ytani01/OttoPi/docs/index.md

OttoPi
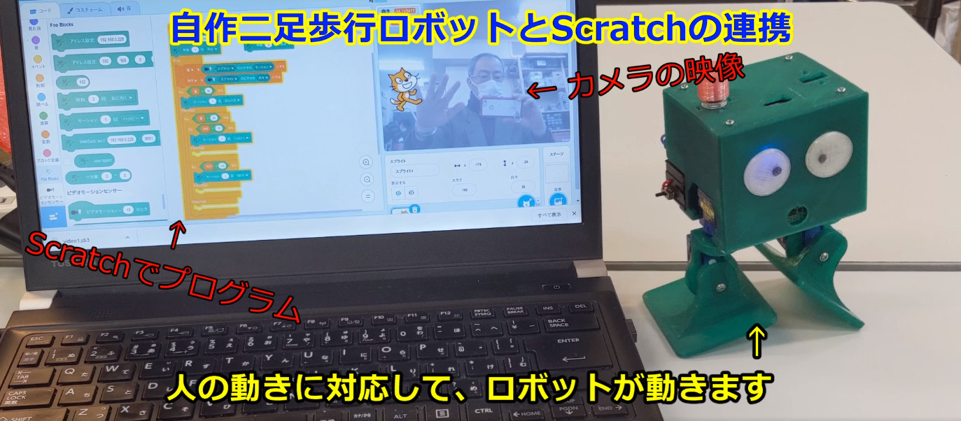
[picture p1: docs/media/OttoPi-Scratch.mp4.jpg]
OttoPi (http://www.ytani.net:8080/tmp/OttoPi/OttoPi-Scratch.mp4)

[Youtube](https://youtu.be/tdhGacsOuL4)

# OttoPi: Otto DIY like biped robot for Raspberry Pi (Zero)

## About

Raspberry Pi Zeroをベースに、
[Otto DIY](https://www.ottodiy.com/)のような
二足歩行ロボットを作って見ました。

Raspberry Piがベースと言うことで、
本家の[Otto DIY](https://www.ottodiy.com/)とは違い、
以下のような特徴があります。

* 距離センサーで障害物を検知して、自動的に歩き回ります。(自動運転モード）
* BLE経由で、スクラッチ(の専用拡張機能)から、制御することができます。(距離センサーの値も取得可能)
* Wi-Fi経由で、スマートフォンからマニュアル操作するこができます。
* 音声合成機能内蔵(OpenJTalk)で、
自由な文章(日本語)をしゃべらせることができます。
* Scrtchの独自拡張機能を利用して、Scratchからロボットを制御できます。

## Control with Scratch 3.0

0. (for Windows) Download and UnZip [`Scratch Link 1.3.66.0`](https://github.com/ytani01/OttoPi/raw/master/ScratchLink/ScratchLink-1.3.66.0.zip)
1. (for PC) run ``Scratch Link``
2. [Scratch & 専用拡張機能](https://ytani01.github.io/scratch-gui/)

## Control with smartphone or PC

``http://{IP address}:5000/``

-----

以下、まだまだドキュメントが未整備で、
最新の状態にできていません。
m(_ _)m

## 3D model

T.B.D

## Hardware

### BOM (Bill of Materials)

| Item | Qty |
|---|-----|
| Raspberry Pi Zero WH | x1 |
| 18650 battery | x1 |
| battery box | x1 |
| SG-90 Servo Motor | x4 | 

### T.B.D.

## Install software

### purge pulseaudio packages

現状、pulseaudioがあると、音声が出ません。
以下のように、pulseaudioを削除してください。

```bash
$ sudo apt purge pulseaudio\*
```

### make Python3 venv

```bash
$ cd ${HOME}
$ python3 -m venv env1
```

### download

```bash
$ cd ~/env1
$ git clone https://www.github.com/ytani01/OttoPi.git
```

### install 

```bash
$ cd ~/env1/OttoPi
$ ./setup.sh
```

## References

* [pigpio](http://abyz.me.uk/rpi/pigpio/)
* [Otto DIY](https://www.ottodiy.com/)
* [Open JTalk](http://open-jtalk.sp.nitech.ac.jp/)
