ytani01/OttoPi/pcb/OttoPi10-RPi3A-HAT/KiCAD/OttoPi10-RPi3A-HAT.pdf

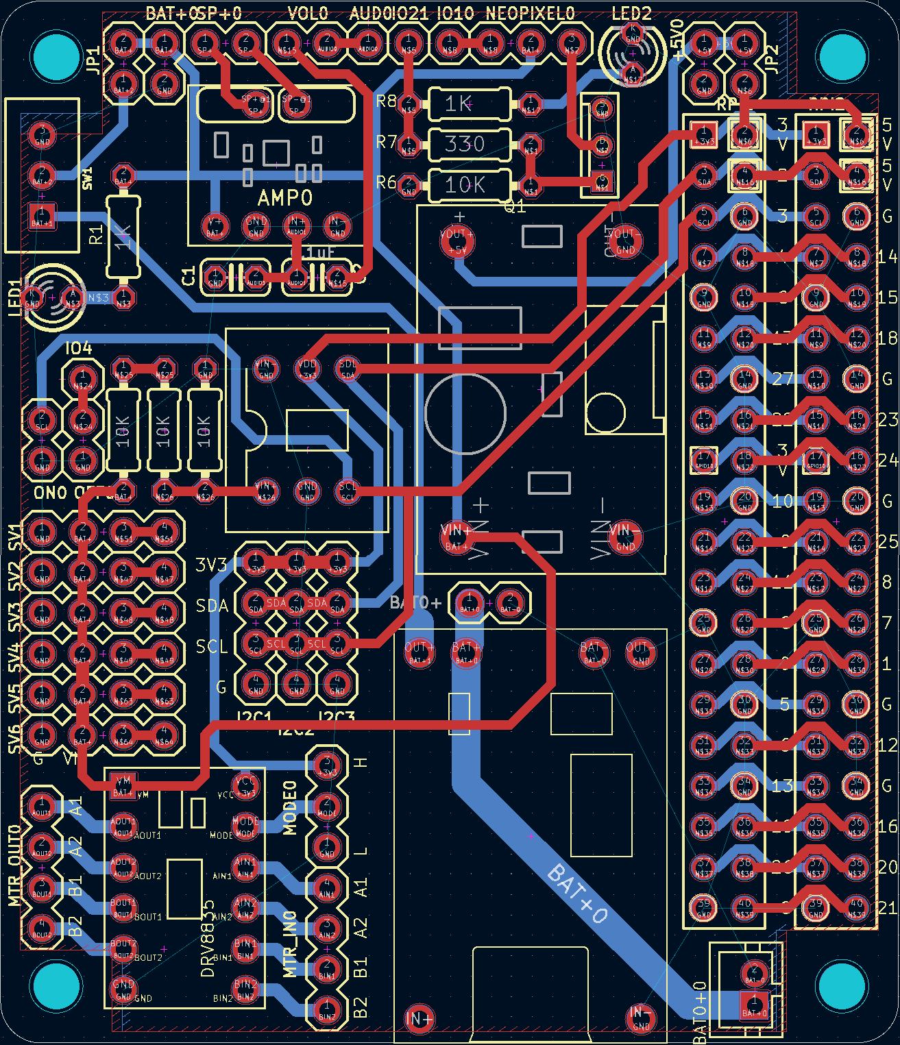
[picture p2: page 1]
