ytani01/OttoPi/docs/media/20210413a1-1.png

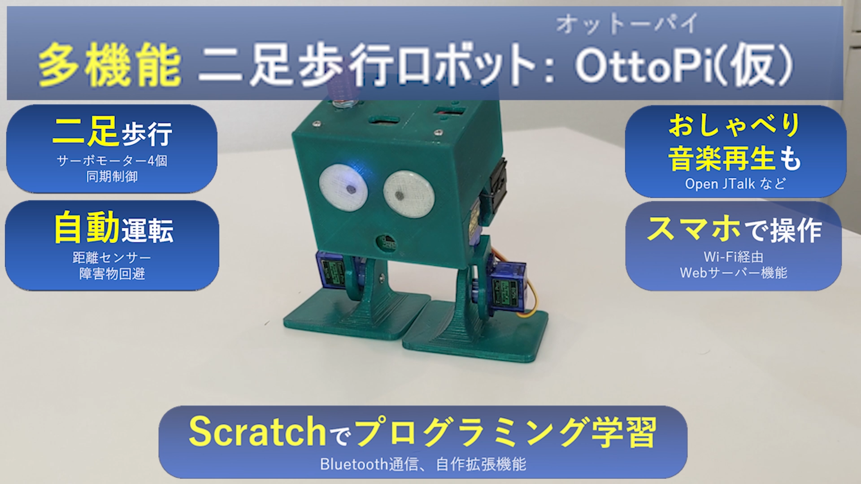
docs/media/20210413a1-1.png
