ytani01/OttoPi/docs/media/20210413a1-2.jpg

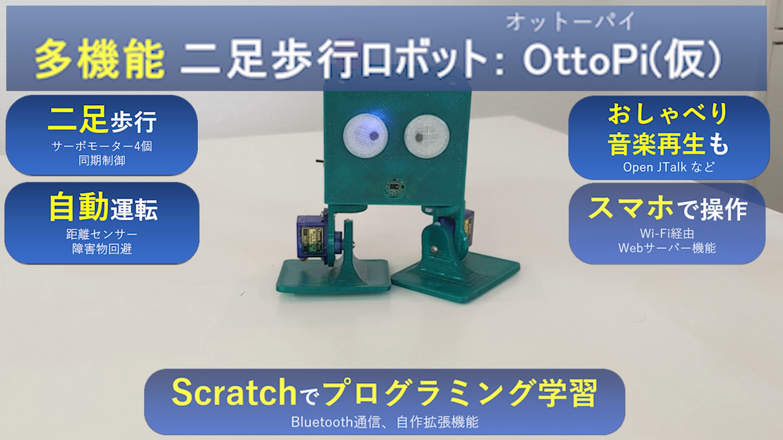
docs/media/20210413a1-2.jpg
