ytani01/OttoPi/docs/media/OttoPi-Web1.png

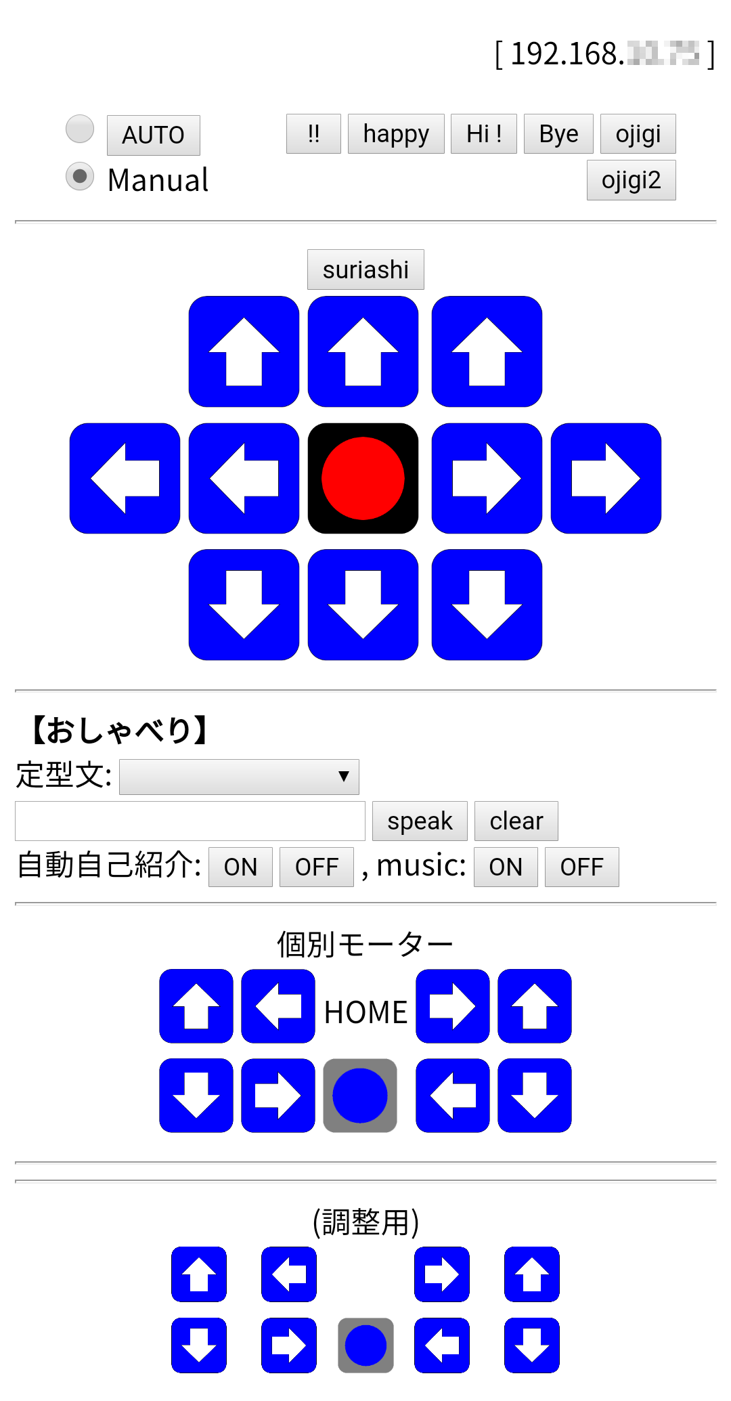
docs/media/OttoPi-Web1.png
