ytani01/OttoPi/docs/media/OttoPi.png

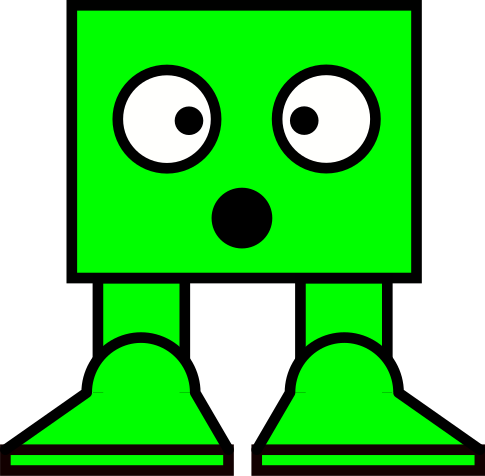
docs/media/OttoPi.png
