ytani01/OttoPi/pcb/OttoPi09-RPi3A-HAT/OttoPi09-Rpi3A-HAT.png

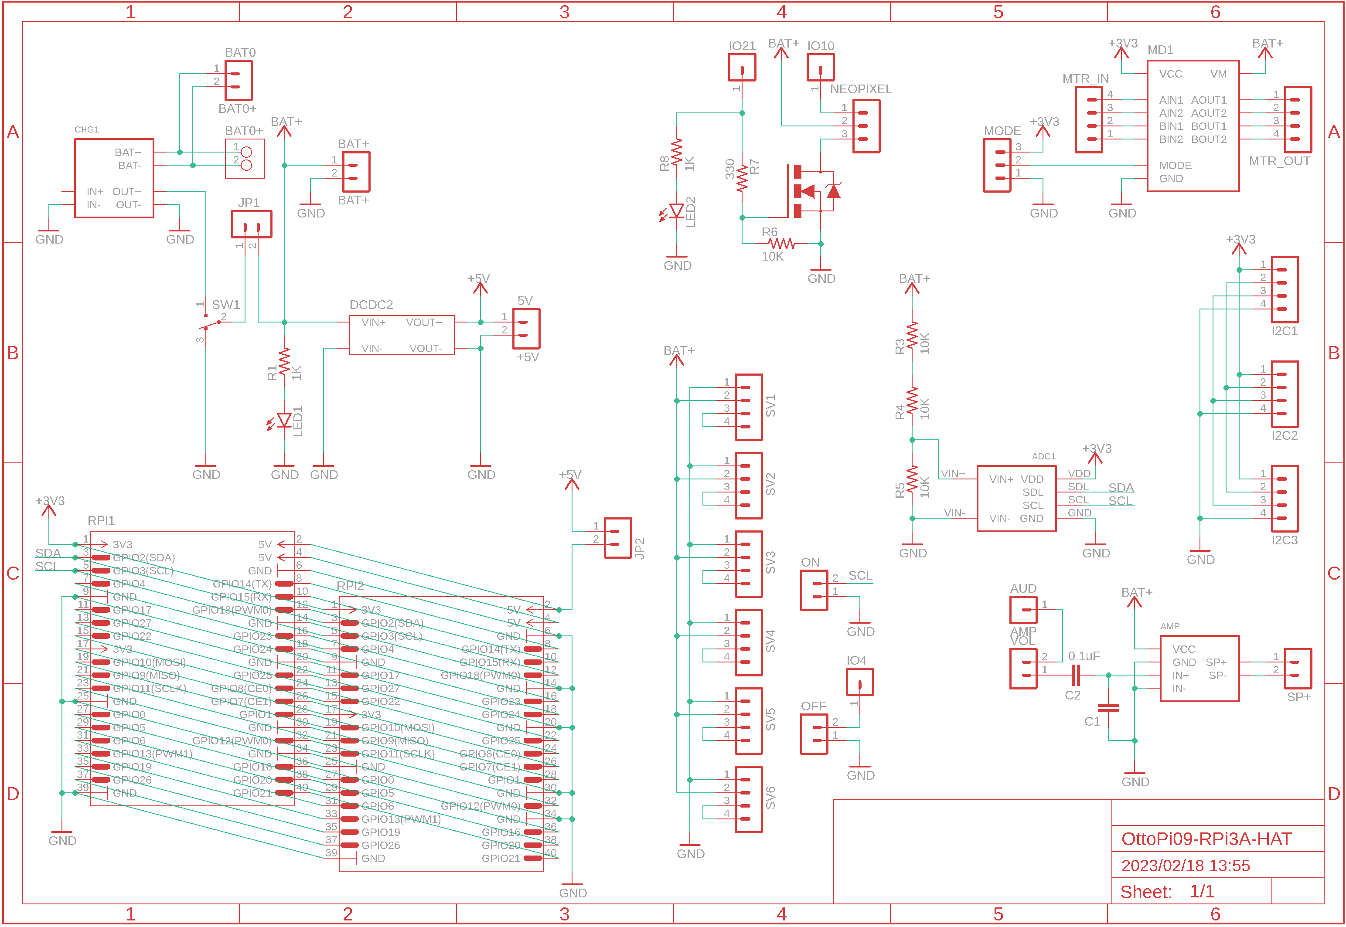
pcb/OttoPi09-RPi3A-HAT/OttoPi09-Rpi3A-HAT.png
