ytani01/OttoPi/static/images/button_blue1.png

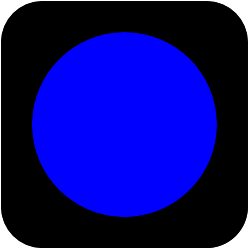
static/images/button_blue1.png
