ytani01/OttoPi/static/images/button_blue2.png

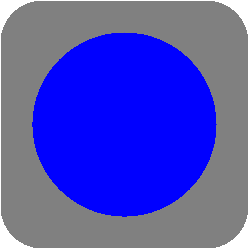
static/images/button_blue2.png
