ytani01/OttoPi/static/images/button_center.png

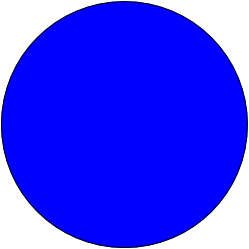
static/images/button_center.png
