ytani01/OttoPi/static/images/button_down.png

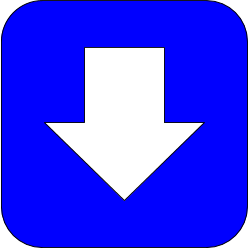
static/images/button_down.png
