ytani01/OttoPi/static/images/button_left.png

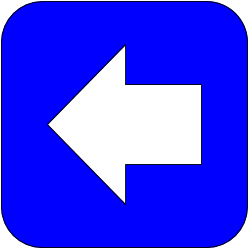
static/images/button_left.png
