ytani01/OttoPi/static/images/button_right.png

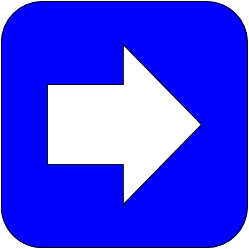
static/images/button_right.png
