ytani01/OttoPi/static/images/button_up.png

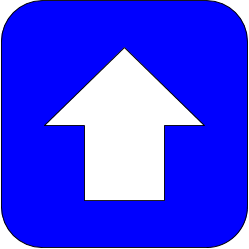
static/images/button_up.png
