ytani01/OttoPi/static/images/Robot_remocon.png

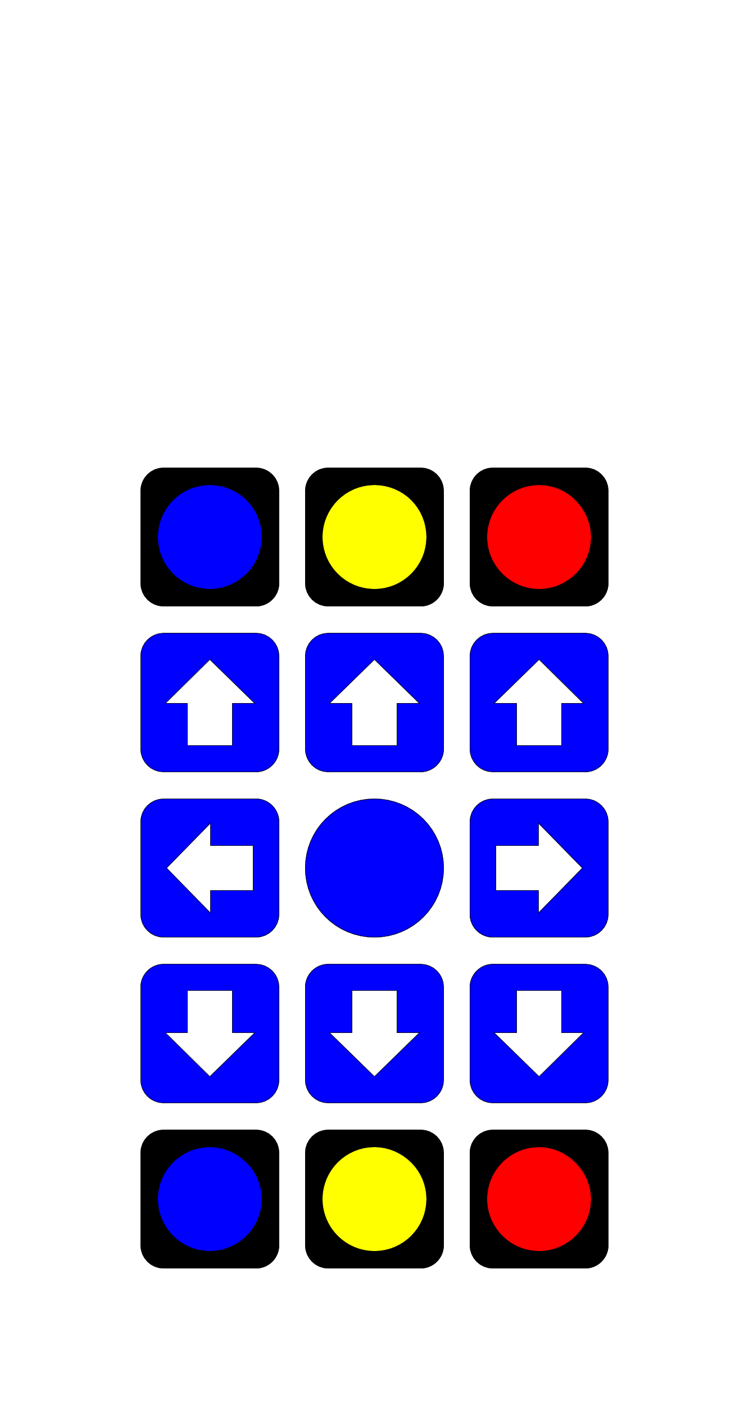
static/images/Robot_remocon.png
