ytani01/OttoPi/(list of files, drawings)

Other design files:
pcb/Fritzing/ButtonLED01a.fzz
pcb/Fritzing/OttoPi-01.fzz
pcb/Fritzing/OttoPi-01a.fzz
pcb/Fritzing/OttoPi-01b.fzz
pcb/Fritzing/OttoPi-02.fzz
pcb/Fritzing/OttoPi-03.fzz
pcb/Fritzing/OttoPi-04.fzz
pcb/Fritzing/OttoPi-05a.fzz
pcb/Fritzing/OttoPi-05b.fzz
pcb/Fritzing/OttoPi-05c.fzz
pcb/Fritzing/OttoPi-06a.fzz
pcb/Fritzing/OttoPi-06b.fzz
pcb/Fritzing/OttoPi-07a.fzz
pcb/Fritzing/OttoPi-07b.fzz
pcb/Fritzing/OttoPi-07c.fzz
pcb/Fritzing/OttoPi-08a.fzz
pcb/Fritzing/OttoPi-08b.fzz
pcb/Fritzing/OttoPi-universal1.fzz
