ytani01/OttoPi/pcb/OttoPi10-RPi3A-HAT/KiCAD/OttoPi10-RPi3A-HAT.kicad_pcb

## KiCad design pcb/OttoPi10-RPi3A-HAT/KiCAD/OttoPi10-RPi3A-HAT.kicad_pcb (2025-03-08)

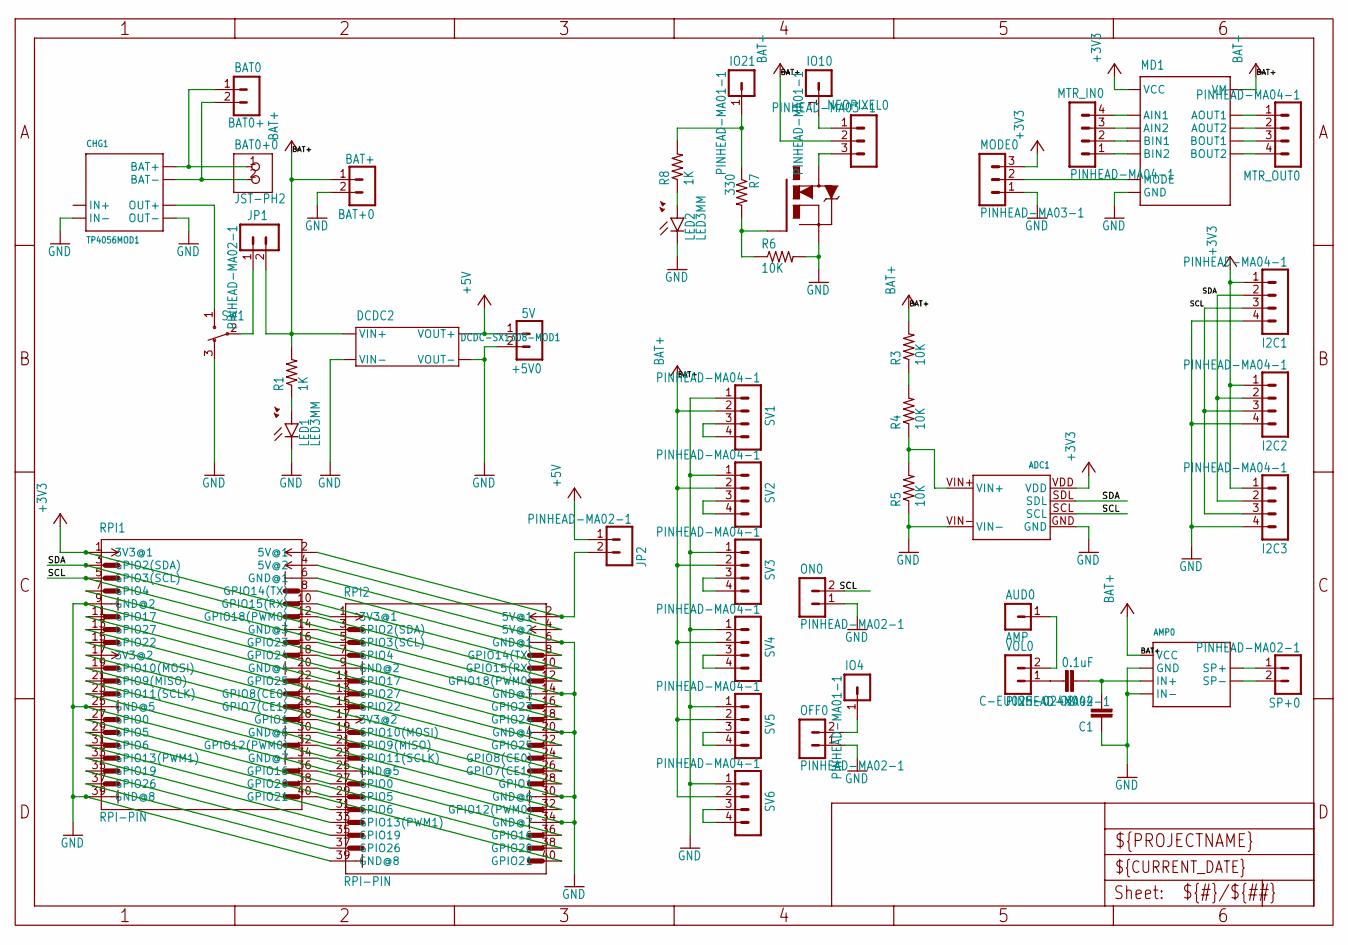
[picture p16: schematic OttoPi10-RPi3A-HAT.kicad_sch]

Parts:
+5V0: 5V; PINHEAD-MA02-1
ADC1: MCP3425MOD
AMP0: AMP; PAM8012MOD-A
AUD0: AMP; PINHEAD-MA01-1
BAT0: BAT0+; PINHEAD-MA02-1
BAT0+0: JST-PH2
BAT+0: BAT+; PINHEAD-MA02-1
C1: C-EU025-024X044; C025-024X044
C2: 0.1uF; C025-024X044
CHG1: TP4056MOD1
DCDC2: DCDC-SX1308-MOD1
I2C1, I2C2, I2C3: PINHEAD-MA04-1
IO4, IO10, IO21: PINHEAD-MA01-1
JP1, JP2: PINHEAD-MA02-1
LED1, LED2: LED3MM
MD1: DRV8835MOD
MODE0: PINHEAD-MA03-1
MTR_IN0: PINHEAD-MA04-1
MTR_OUT0: PINHEAD-MA04-1
NEOPIXEL0: PINHEAD-MA03-1
OFF0: PINHEAD-MA02-1
ON0: PINHEAD-MA02-1
Q1: 2SK4017; MOSFET-1
R1, R8: 1K; 0204_7
R3, R4, R5, R6: 10K; 0204_7
R7: 330; 0204_7
RPI1, RPI2: RPI-PIN
SP+0: PINHEAD-MA02-1
SV1, SV2, SV3, SV4, SV5, SV6: PINHEAD-MA04-1
SW1: SW3-1
VOL0: PINHEAD-MA02-1

Connections:
+3V3: ADC1.VDD, I2C1.1, I2C2.1, I2C3.1, MD1.VCC, MODE0.3, RPI1.1 (3V3@1), RPI2.1 (3V3@1)
+5V: +5V0.1, DCDC2.VOUT+, JP2.1
AIN1: MD1.AIN1, MTR_IN0.4
AIN2: MD1.AIN2, MTR_IN0.3
AOUT1: MD1.AOUT1, MTR_OUT0.1
AOUT2: MD1.AOUT2, MTR_OUT0.2
AUDIO0: AUD0.1, VOL0.2
AUDIO1: AMP0.IN+, C1.2, C2.1
BAT+: AMP0.V+ (VCC), BAT+0.1, DCDC2.VIN+, JP1.2, MD1.VM, NEOPIXEL0.2, R1.2, R3.2, SV1.2, SV2.2, SV3.2, SV4.2, SV5.2, SV6.2
BAT+0: BAT0.1, BAT0+0.1, CHG1.BAT+
BAT+1: CHG1.OUT+, SW1.1
BAT+2: JP1.1, SW1.2
BAT-0: BAT0.2, BAT0+0.2, CHG1.BAT-
BIN1: MD1.BIN1, MTR_IN0.2
BIN2: MD1.BIN2, MTR_IN0.1
BOUT1: MD1.BOUT1, MTR_OUT0.3
BOUT2: MD1.BOUT2, MTR_OUT0.4
GND: +5V0.2, ADC1.GND, ADC1.VIN-, AMP0.GND, AMP0.IN-, BAT+0.2, C1.1, CHG1.IN-, CHG1.OUT-, DCDC2.VIN-, DCDC2.VOUT-, I2C1.4, I2C2.4, I2C3.4, LED1.K (C), LED2.K (C), MD1.GND, MODE0.1, OFF0.1, ON0.1, Q1.S, R5.1, R6.2, RPI1.6 (GND@1), RPI1.9 (GND@2), RPI1.14 (GND@3), RPI1.20 (GND@4), RPI1.25 (GND@5), RPI1.30 (GND@6), RPI1.34 (GND@7), RPI1.39 (GND@8), RPI2.6 (GND@1), RPI2.9 (GND@2), RPI2.14 (GND@3), RPI2.20 (GND@4), RPI2.25 (GND@5), RPI2.30 (GND@6), RPI2.34 (GND@7), RPI2.39 (GND@8), SV1.1, SV2.1, SV3.1, SV4.1, SV5.1, SV6.1, SW1.3
GPIO10: RPI1.17 (3V3@2), RPI2.17 (3V3@2)
MODE: MD1.MODE, MODE0.2
unnamed: Q1.G, R6.1, R7.2
unnamed: NEOPIXEL0.3, Q1.D
unnamed: LED1.A, R1.1
unnamed: IO21.1, R7.1, R8.2
unnamed: JP2.2, RPI1.2 (5V@1), RPI2.2 (5V@1)
unnamed: RPI1.7 (GPIO4), RPI2.7 (GPIO4)
unnamed: IO10.1, NEOPIXEL0.1
unnamed: RPI1.11 (GPIO17), RPI2.11 (GPIO17)
unnamed: RPI1.13 (GPIO27), RPI2.13 (GPIO27)
unnamed: RPI1.15 (GPIO22), RPI2.15 (GPIO22)
unnamed: RPI1.23 (GPIO11(SCLK)), RPI2.23 (GPIO11(SCLK))
unnamed: RPI1.19 (GPIO10(MOSI)), RPI2.19 (GPIO10(MOSI))
unnamed: RPI1.21 (GPIO9(MISO)), RPI2.21 (GPIO9(MISO))
unnamed: C2.2, VOL0.1
unnamed: RPI1.4 (5V@2), RPI2.4 (5V@2)
unnamed: LED2.A, R8.1
unnamed: RPI1.8 (GPIO14(TX)), RPI2.8 (GPIO14(TX))
unnamed: RPI1.10 (GPIO15(RX)), RPI2.10 (GPIO15(RX))
unnamed: RPI1.12 (GPIO18(PWM0)), RPI2.12 (GPIO18(PWM0))
unnamed: RPI1.16 (GPIO23), RPI2.16 (GPIO23)
unnamed: RPI1.18 (GPIO24), RPI2.18 (GPIO24)
unnamed: RPI1.22 (GPIO25), RPI2.22 (GPIO25)
unnamed: IO4.1, OFF0.2
unnamed: R3.1, R4.2
unnamed: ADC1.VIN+, R4.1, R5.2
unnamed: RPI1.24 (GPIO8(CE0)), RPI2.24 (GPIO8(CE0))
unnamed: RPI1.26 (GPIO7(CE1)), RPI2.26 (GPIO7(CE1))
unnamed: RPI1.27 (GPIO0), RPI2.27 (GPIO0)
unnamed: RPI1.28 (GPIO1), RPI2.28 (GPIO1)
unnamed: RPI1.29 (GPIO5), RPI2.29 (GPIO5)
unnamed: RPI1.31 (GPIO6), RPI2.31 (GPIO6)
unnamed: RPI1.32 (GPIO12(PWM0)), RPI2.32 (GPIO12(PWM0))
unnamed: RPI1.33 (GPIO13(PWM1)), RPI2.33 (GPIO13(PWM1))
unnamed: RPI1.35 (GPIO19), RPI2.35 (GPIO19)
unnamed: RPI1.36 (GPIO16), RPI2.36 (GPIO16)
unnamed: RPI1.37 (GPIO26), RPI2.37 (GPIO26)
unnamed: RPI1.38 (GPIO20), RPI2.38 (GPIO20)
unnamed: RPI1.40 (GPIO21), RPI2.40 (GPIO21)
unnamed: SV2.3, SV2.4
unnamed: SV3.3, SV3.4
unnamed: SV4.3, SV4.4
unnamed: SV1.3, SV1.4
unnamed: SV5.3, SV5.4
unnamed: SV6.3, SV6.4
SCL: ADC1.SCL, I2C1.3, I2C2.3, I2C3.3, ON0.2, RPI1.5 (GPIO3(SCL)), RPI2.5 (GPIO3(SCL))
SDA: ADC1.SDL, I2C1.2, I2C2.2, I2C3.2, RPI1.3 (GPIO2(SDA)), RPI2.3 (GPIO2(SDA))
SP+: AMP0.SP+@1 (SP+), SP+0.1
SP-: AMP0.SP-@1 (SP-), SP+0.2

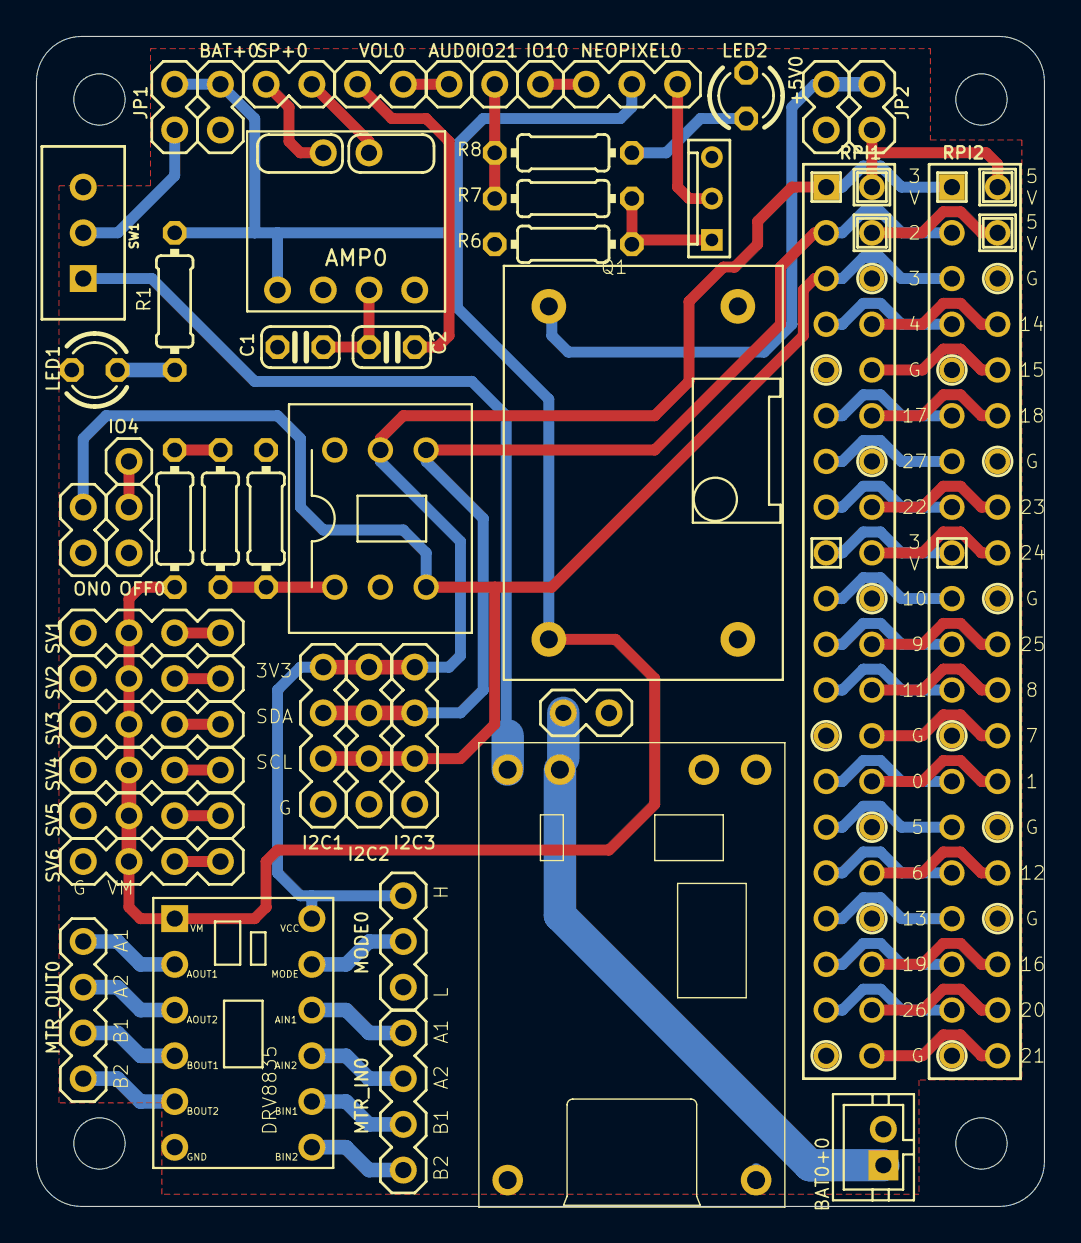
[picture p17: board OttoPi10-RPi3A-HAT.kicad_pcb from above]

Board: 2 copper layers, 56.0 x 65.0 mm, 51 parts (0 on the bottom side), 68 nets.

Other parts of the board:
UNK_HOLE_0: dummyfp0
UNK_HOLE_1: dummyfp1
UNK_HOLE_2: dummyfp2
UNK_HOLE_3: dummyfp3
