ytani01/OttoPi/pcb/OttoPi04c-RPiZeroHAT/OttoPi04b.brd

## EAGLE design pcb/OttoPi04c-RPiZeroHAT/OttoPi04b.brd (2020-09-21)

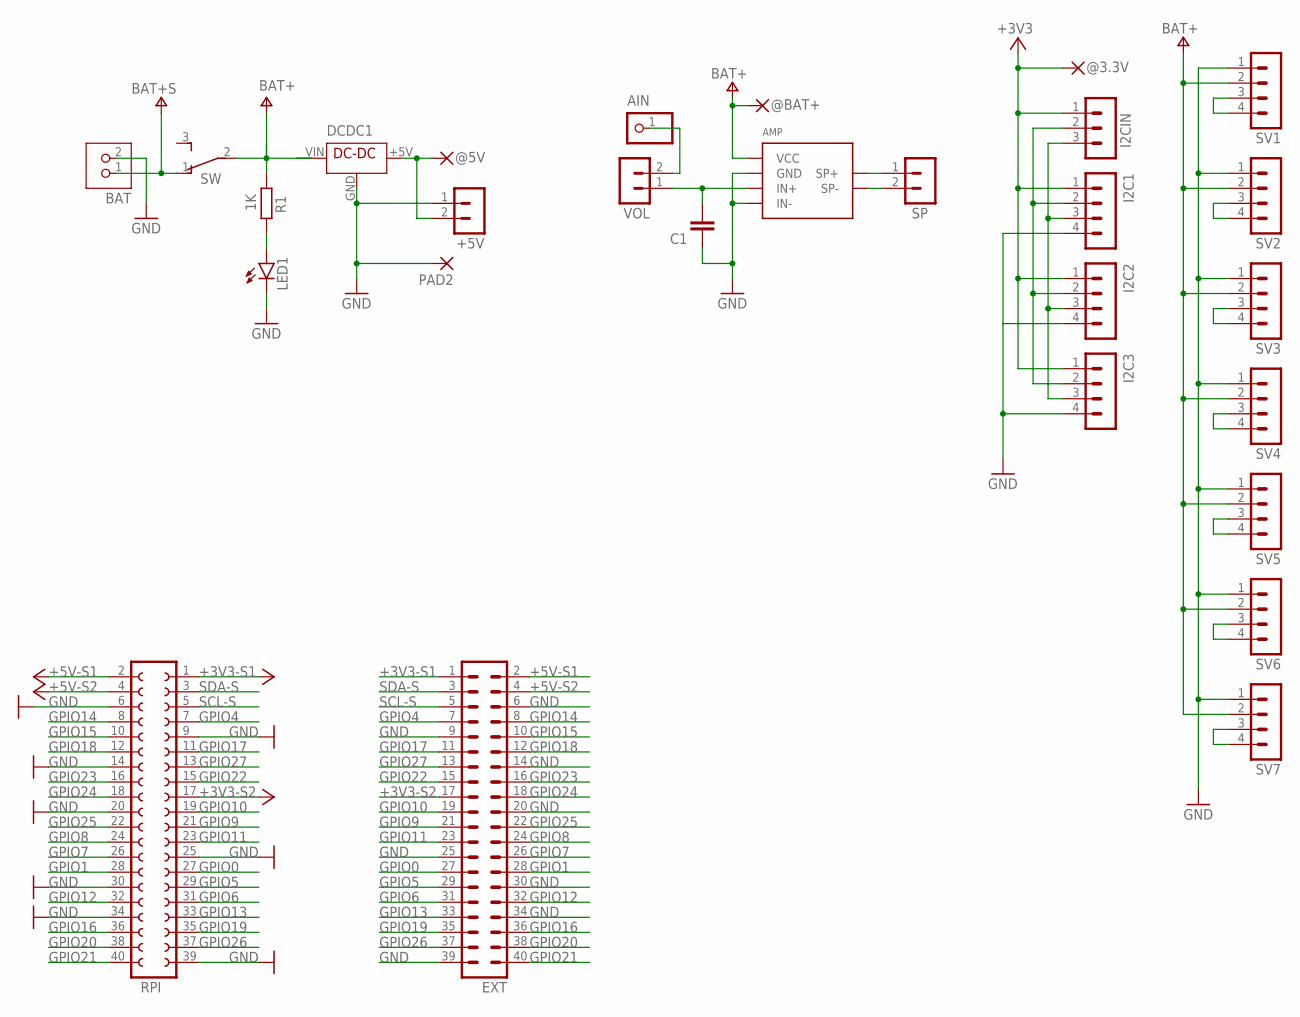
[picture p20: schematic OttoPi04b.sch]

Parts:
+5V: MA02-1
@3.3V, @5V: 1,6/0,9
@BAT+: 1,6/0,9
AIN: PINHD-1X1; 1X01
AMP: PAM8012MOD; PAM8012MOD-A
BAT: JST-PH2
C1: C-EU025-024X044; C025-024X044
DCDC1: DCDC-5V-0.48A
EXT: MA20-2
I2C1, I2C2, I2C3: MA04-1
I2CIN: MA03-1
LED1: LED3MM
PAD2: 1,6/0,9
R1: 1K; 0204/7
RPI: FE20-2
SP: MA02-1
SV1, SV2, SV3, SV4, SV5, SV6, SV7: MA04-1
SW: TL36PO; TL3XPO
VOL: MA02-1

Connections:
+3V3: @3.3V.1, I2C1.1, I2C2.1, I2C3.1, I2CIN.1
+3V3-S1: EXT.1, RPI.1
+3V3-S2: EXT.17, RPI.17
+4V_S: BAT.1, SW.1 (O)
+5V: +5V.2, @5V.1, DCDC1.+5V (VOUT)
+5V-S1: EXT.2, RPI.2
+5V-S2: EXT.4, RPI.4
AIN: AMP.IN+, C1.1, VOL.1
GND: +5V.1, AMP.GND, AMP.IN-, BAT.2, C1.2, DCDC1.GND, EXT.6, EXT.9, EXT.14, EXT.20, EXT.25, EXT.30, EXT.34, EXT.39, I2C1.4, I2C2.4, I2C3.4, LED1.K (C), PAD2.1, RPI.6, RPI.9, RPI.14, RPI.20, RPI.25, RPI.30, RPI.34, RPI.39, SV1.1, SV2.1, SV3.1, SV4.1, SV5.1, SV6.1, SV7.1
GPIO0: EXT.27, RPI.27
GPIO1: EXT.28, RPI.28
GPIO4: EXT.7, RPI.7
GPIO5: EXT.29, RPI.29
GPIO6: EXT.31, RPI.31
GPIO7: EXT.26, RPI.26
GPIO8: EXT.24, RPI.24
GPIO9: EXT.21, RPI.21
GPIO10: EXT.19, RPI.19
GPIO11: EXT.23, RPI.23
GPIO12: EXT.32, RPI.32
GPIO13: EXT.33, RPI.33
GPIO14: EXT.8, RPI.8
GPIO15: EXT.10, RPI.10
GPIO16: EXT.36, RPI.36
GPIO17: EXT.11, RPI.11
GPIO18: EXT.12, RPI.12
GPIO19: EXT.35, RPI.35
GPIO20: EXT.38, RPI.38
GPIO21: EXT.40, RPI.40
GPIO22: EXT.15, RPI.15
GPIO23: EXT.16, RPI.16
GPIO24: EXT.18, RPI.18
GPIO25: EXT.22, RPI.22
GPIO26: EXT.37, RPI.37
GPIO27: EXT.13, RPI.13
LED: LED1.A, R1.1
unnamed: AIN.1, VOL.2
unnamed: SV6.3, SV6.4
unnamed: SV7.3, SV7.4
SCL: I2C1.3, I2C2.3, I2C3.3, I2CIN.3
SCL-S: EXT.5, RPI.5
SDA-S: EXT.3, RPI.3
SDL: I2C1.2, I2C2.2, I2C3.2, I2CIN.2
SP+: AMP.SP+@1 (SP+), SP.1
SP-: AMP.SP-@1 (SP-), SP.2
SV1: SV5.3, SV5.4
SV2: SV4.3, SV4.4
SV3: SV3.3, SV3.4
SV4: SV2.3, SV2.4
SV5: SV1.3, SV1.4
V+: @BAT+.1, AMP.V+ (VCC), DCDC1.VIN, R1.2, SV1.2, SV2.2, SV3.2, SV4.2, SV5.2, SV6.2, SV7.2, SW.2

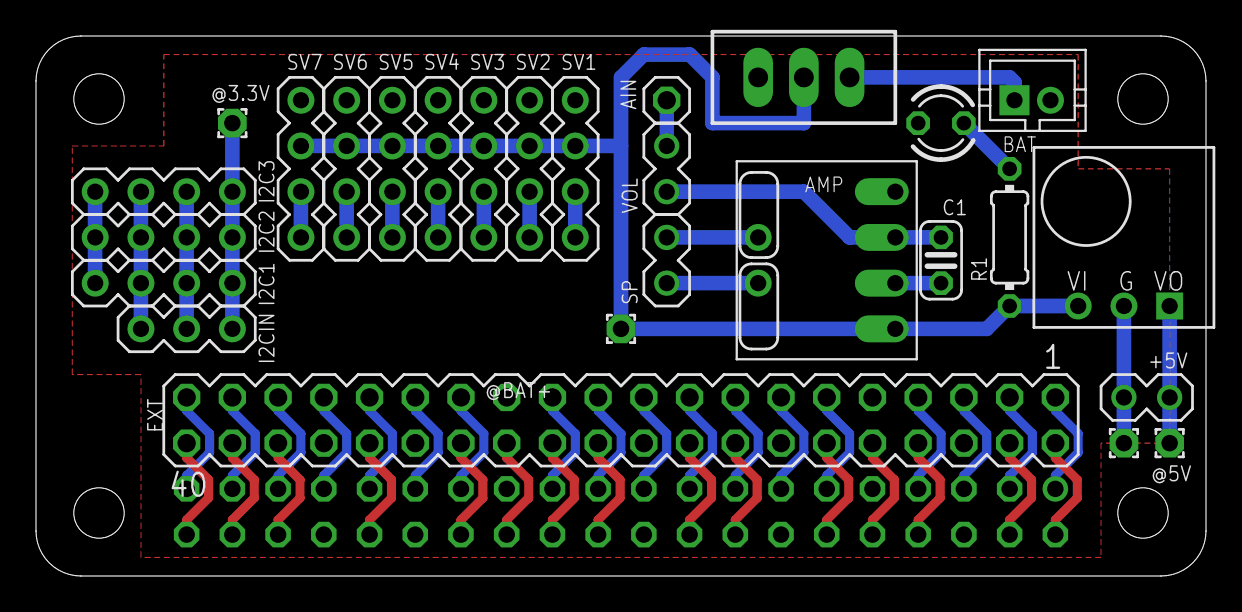
[picture p21: board OttoPi04b.brd from above]

Board: 2 copper layers, 65.0 x 30.0 mm, 28 parts (1 on the bottom side), 51 nets.
