ytani01/OttoPi/(commit log)

2020-09-04 update pcb
    [OttoPi01.brd, OttoPi01.sch]
2020-12-28 [update] PCB
    [OttoPi06a-RPi3AHAT.brd, OttoPi06a-RPi3AHAT.sch]
2021-09-21 ADD: pcb/OttoPi08-RPi3AHAT
    [OttoPi06a-RPi3AHAT.brd, OttoPi06a-RPi3AHAT.sch, OttoPi08-RPi3AHAT.brd, OttoPi08-RPi3AHAT.sch]
2021-09-22 UPD: pcb/OttoPi08-RPi3AHAT
    [OttoPi08-RPi3AHAT.brd]
2021-09-27 ADD: pcb/OttoPi09-RPi3A-HAT
    [OttoPi09-RPi3A-HAT.brd, OttoPi09-RPi3A-HAT.sch]
2021-09-30 UPD: pcb
    [OttoPi09-RPi3A-HAT.brd, OttoPi09-RPi3A-HAT.sch]
2023-02-20 ADD: pcb/OttoPi10-
    [OttoPi10-RPi3A-HAT.brd, OttoPi10-RPi3A-HAT.sch]
2025-03-08 ADD: pcb/.../KiCAD/
    [OttoPi10-RPi3A-HAT.kicad_pcb, OttoPi10-RPi3A-HAT.kicad_sch]
2025-11-12 ADD: pcb/OttoPi10-Rpi3A-HAT/..
